MAVProxyUser/AlienWhoopF7/AlienWhoopF7-ESP32.brd

## EAGLE design AlienWhoopF7-ESP32.brd (2026-08-31)

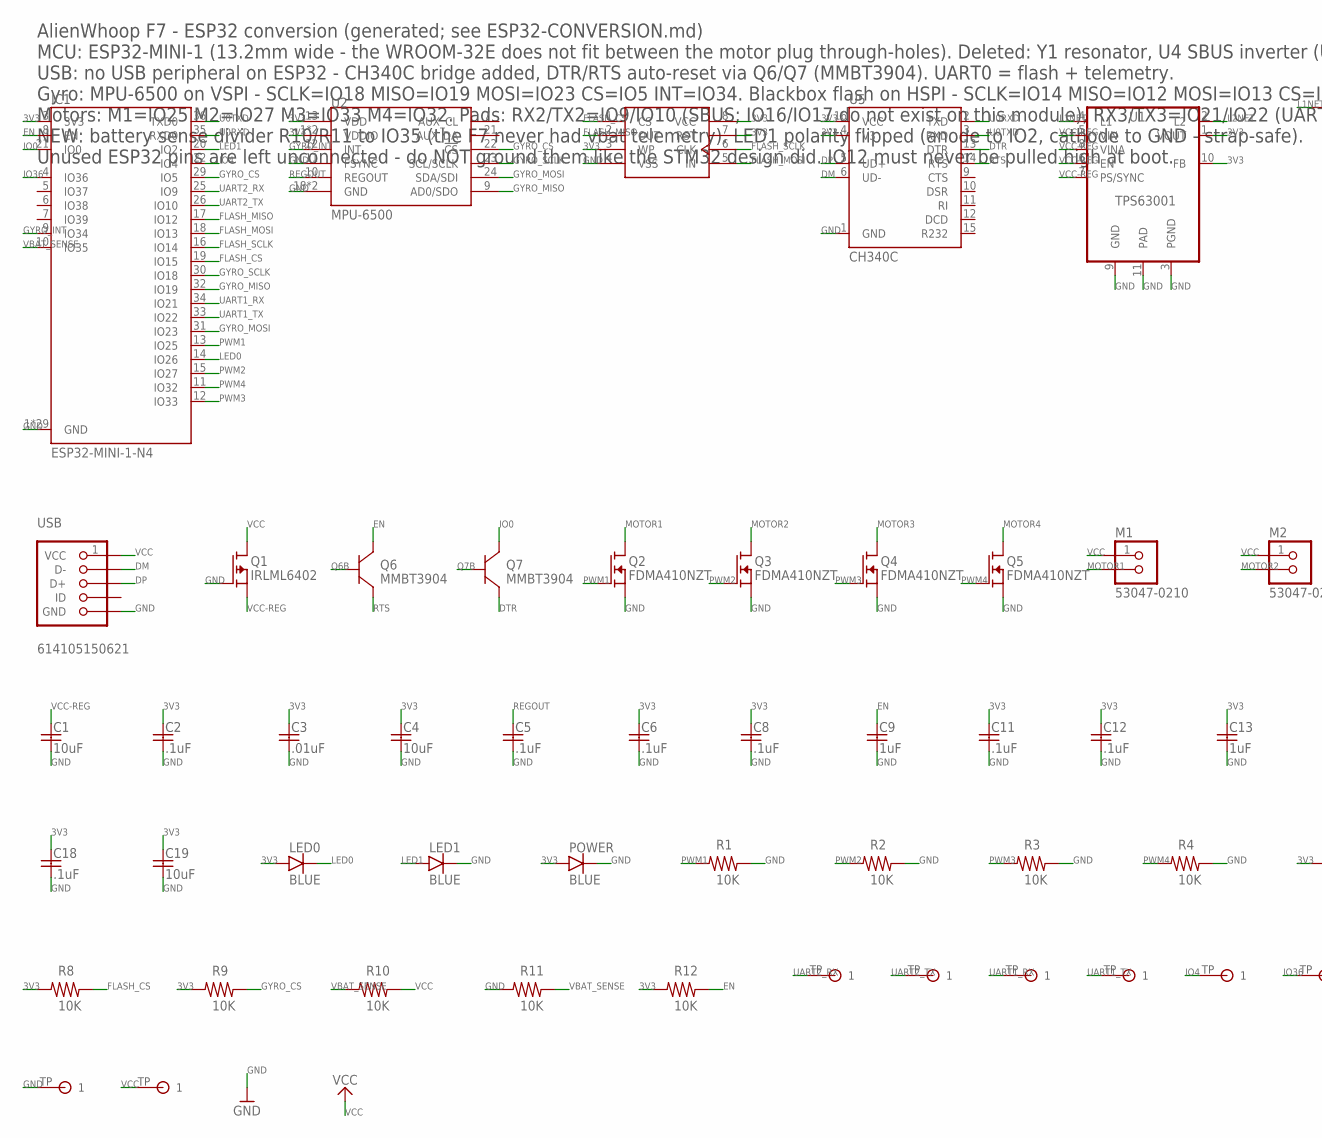
[picture p1: schematic AlienWhoopF7-ESP32.sch, part in row 1, column 1]

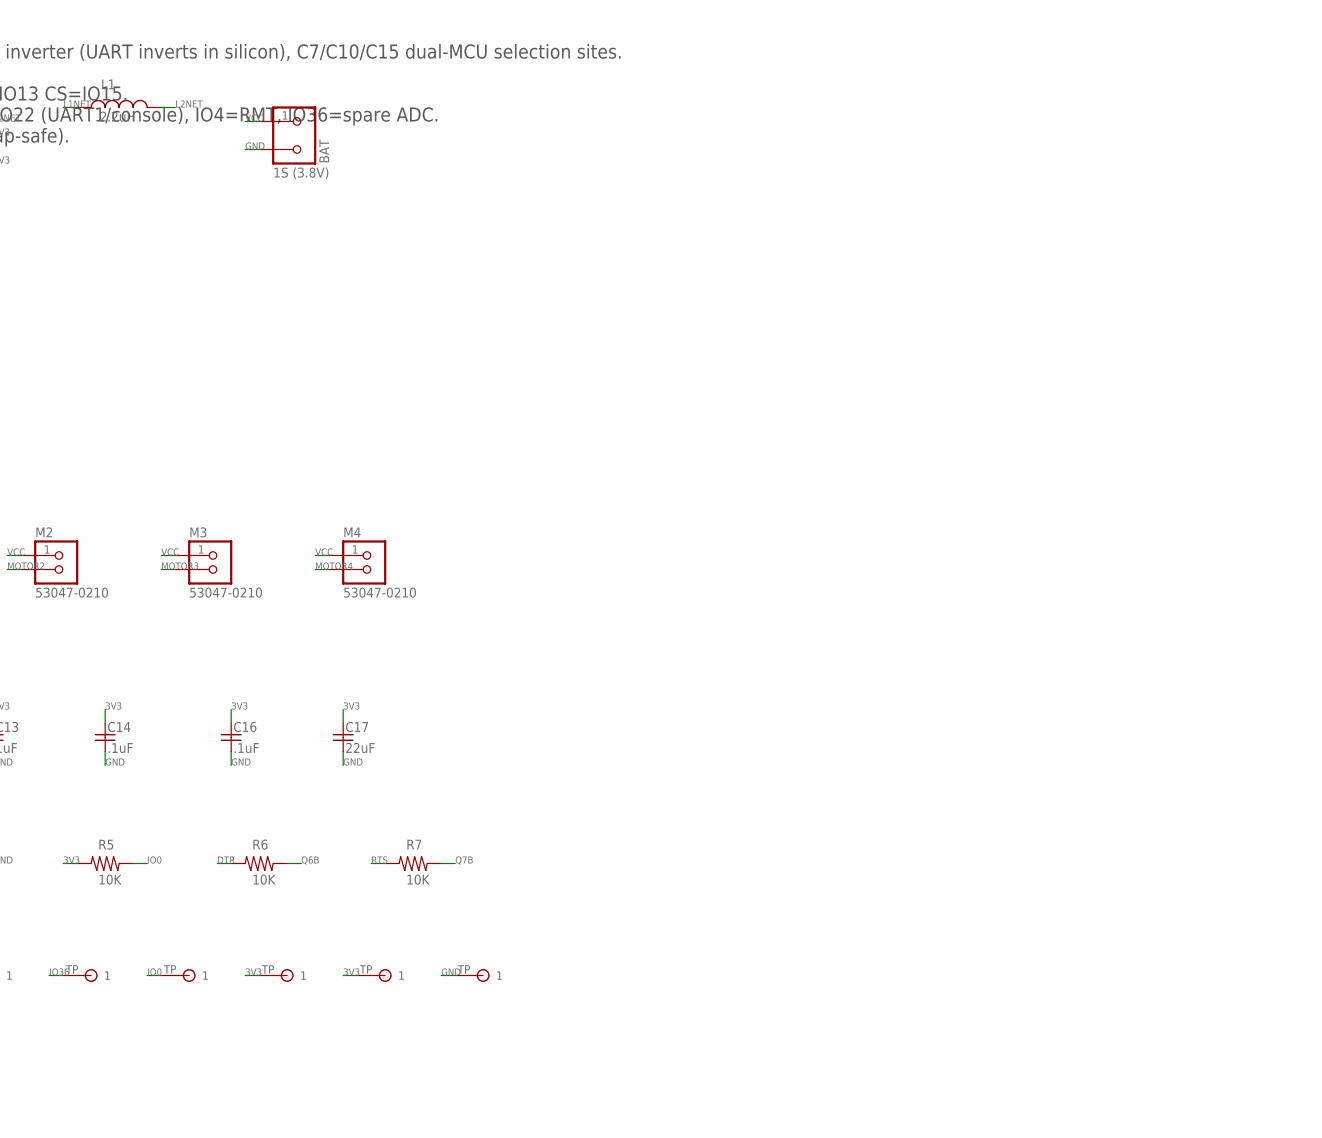
[picture p2: schematic AlienWhoopF7-ESP32.sch, part in row 1, column 2]

Parts:
3.3V, 3V3: TESTPAD
BAT: 1S (3.8V); S2B-PH-K-S
BOOT: TESTPAD
C1, C4, C19: 10uF; YUDEN-CAP-0805
C2, C5, C6, C8, C11, C12, C14, C16, C18: .1uF; MUR-CAP-0603
C3: .01uF; MUR-CAP-0603
C9, C13: 1uF; MUR-CAP-0603
C17: 22uF; YUDEN-CAP-0805
GND: TESTPAD
GND@1: TESTPAD
IC1: ESP32-MINI-1-N4; ESP32-MINI-1
IO4, IO36: TESTPAD
L1: 2.2uH; DFE201612E-2R2M-P2
LED0, LED1: BLUE; SMD-CHIP-LED-0805
M1, M2, M3, M4: 53047-0210; PICO-53047-02
POWER: BLUE; SMD-CHIP-LED-0805
Q1: IRLML6402; SOT-23
Q2, Q3, Q4, Q5: FDMA410NZT; MICROFET-2X2
Q6, Q7: MMBT3904; SOT23
R1, R2, R3, R4, R5, R6, R7, R8, R9, R10, R11, R12: 10K; VISH-RES-0603
RX2, RX3: TESTPAD
TX2, TX3: TESTPAD
U1: TPS63001; VSON-N10
U2: MPU-6500; QFN24_PAD
U3: MX25L6406EM2I-12G; M25P32
U5: CH340C; SOP16
USB: 614105150621; USB-BFPV
VCC@1: TESTPAD

Connections:
3V3: 3.3V.TP, 3V3.TP, C2.1, C3.1, C4.1, C6.1, C8.1, C11.1, C12.1, C13.1, C14.1, C16.1, C17.1, C18.1, C19.1, IC1.3 (3V3), LED0.A, POWER.A, R5.2, R8.2, R9.2, R12.2, U1.1 (VOUT), U1.10 (FB), U2.1 (VDDIO), U2.8 (VDDIO), U2.13 (VDD), U3.3 (WP), U3.7 (RST), U3.8 (VCC), U5.4 (V3), U5.16 (VCC)
DM: U5.6 (UD-), USB.2 (D-)
DP: U5.5 (UD+), USB.3 (D+)
DTR: Q7.2 (E), R6.2, U5.13 (DTR)
EN: C9.1, IC1.8 (EN), Q6.3 (C), R12.1
FLASH_CS: IC1.19 (IO15), R8.1, U3.1 (CS)
FLASH_MISO: IC1.17 (IO12), U3.2 (OUT)
FLASH_MOSI: IC1.18 (IO13), U3.5 (IN)
FLASH_SCLK: IC1.16 (IO14), U3.6 (CLK)
GND: BAT.2, C1.2, C2.2, C3.2, C4.2, C5.2, C6.2, C8.2, C9.2, C11.2, C12.2, C13.2, C14.2, C16.2, C17.2, C18.2, C19.2, GND.TP, GND@1.TP, IC1.1 (GND), IC1.2 (GND), IC1.27 (GND), IC1.38 (GND), IC1.39 (GND), IC1.40 (GND), IC1.41 (GND), IC1.42 (GND), IC1.43 (GND), IC1.44 (GND), IC1.45 (GND), IC1.46 (GND), IC1.47 (GND), IC1.48 (GND), IC1.49 (GND), IC1.50 (GND), IC1.51 (GND), IC1.52 (GND), IC1.53 (GND), IC1.54 (GND), IC1.55 (GND), IC1.T1 (GND), IC1.T2 (GND), IC1.T3 (GND), IC1.T4 (GND), IC1.T5 (GND), IC1.T6 (GND), IC1.T7 (GND), IC1.T8 (GND), LED1.C, POWER.C, Q1.1 (G), Q2.S, Q2.S1 (S), Q3.S, Q3.S1 (S), Q4.S, Q4.S1 (S), Q5.S, Q5.S1 (S), R1.1, R2.1, R3.1, R4.1, R11.2, U1.3 (PGND), U1.9 (GND), U1.11 (PAD), U2.11 (FSYNC), U2.18 (GND), U2.20 (GND), U3.4 (VSS), U5.1 (GND), USB.5 (GND), USB.P$6 (GND), USB.P$7 (GND)
GYRO_CS: IC1.29 (IO5), R9.1, U2.22 (!CS)
GYRO_INT: IC1.9 (IO34), U2.12 (INT)
GYRO_MISO: IC1.32 (IO19), U2.9 (AD0/SDO)
GYRO_MOSI: IC1.31 (IO23), U2.24 (SDA/SDI)
GYRO_SCLK: IC1.30 (IO18), U2.23 (SCL/SCLK)
IO0: BOOT.TP, IC1.21 (IO0), Q7.3 (C), R5.1
IO4: IC1.22 (IO4), IO4.TP
IO36: IC1.4 (IO36), IO36.TP
L1NET: L1.P$1 (1), U1.4 (L1)
L2NET: L1.P$2 (2), U1.2 (L2)
LED0: IC1.14 (IO26), LED0.C
LED1: IC1.20 (IO2), LED1.A
MOTOR1: M1.2, Q2.D, Q2.D1 (D), Q2.D2 (D), Q2.D3 (D), Q2.D4 (D)
MOTOR2: M2.2, Q3.D, Q3.D1 (D), Q3.D2 (D), Q3.D3 (D), Q3.D4 (D)
MOTOR3: M3.2, Q4.D, Q4.D1 (D), Q4.D2 (D), Q4.D3 (D), Q4.D4 (D)
MOTOR4: M4.2, Q5.D, Q5.D1 (D), Q5.D2 (D), Q5.D3 (D), Q5.D4 (D)
PWM1: IC1.13 (IO25), Q2.G, R1.2
PWM2: IC1.15 (IO27), Q3.G, R2.2
PWM3: IC1.12 (IO33), Q4.G, R3.2
PWM4: IC1.11 (IO32), Q5.G, R4.2
Q6B: Q6.1 (B), R6.1
Q7B: Q7.1 (B), R7.1
REGOUT: C5.1, U2.10 (REGOUT)
RTS: Q6.2 (E), R7.2, U5.14 (RTS)
U0RXD: IC1.35 (RXD0), U5.2 (TXD)
U0TXD: IC1.36 (TXD0), U5.3 (RXD)
UART1_RX: IC1.34 (IO21), RX3.TP
UART1_TX: IC1.33 (IO22), TX3.TP
UART2_RX: IC1.25 (IO9), RX2.TP
UART2_TX: IC1.26 (IO10), TX2.TP
VBAT_SENSE: IC1.10 (IO35), R10.2, R11.1
VCC: BAT.1, M1.1, M2.1, M3.1, M4.1, Q1.3 (D), R10.1, USB.1 (VCC), VCC@1.TP
VCC-REG: C1.1, Q1.2 (S), U1.5 (VIN), U1.6 (EN), U1.7 (PS/SYNC), U1.8 (VINA)

Notes on the sheet:
AlienWhoop F7 - ESP32 conversion (generated; see ESP32-CONVERSION.md)
MCU: ESP32-MINI-1 (13.2mm wide - the WROOM-32E does not fit between the motor plug through-holes). Deleted: Y1 resonator, U4 SBUS inverter (UART inverts in silicon), C7/C10/C15 dual-MCU selection sites.
USB: no USB peripheral on ESP32 - CH340C bridge added, DTR/RTS auto-reset via Q6/Q7 (MMBT3904). UART0 = flash + telemetry.
Gyro: MPU-6500 on VSPI - SCLK=IO18 MISO=IO19 MOSI=IO23 CS=IO5 INT=IO34. Blackbox flash on HSPI - SCLK=IO14 MISO=IO12 MOSI=IO13 CS=IO15.
Motors: M1=IO25 M2=IO27 M3=IO33 M4=IO32. Pads: RX2/TX2=IO9/IO10 (SBUS; IO16/IO17 do not exist on this module), RX3/TX3=IO21/IO22 (UART1/console), IO4=RMT, IO36=spare ADC.
NEW: battery sense divider R10/R11 to IO35 (the F7 never had vbat telemetry). LED1 polarity flipped (anode to IO2, cathode to GND - strap-safe).
Unused ESP32 pins are left unconnected - do NOT ground them like the STM32 design did. IO12 must never be pulled high at boot.

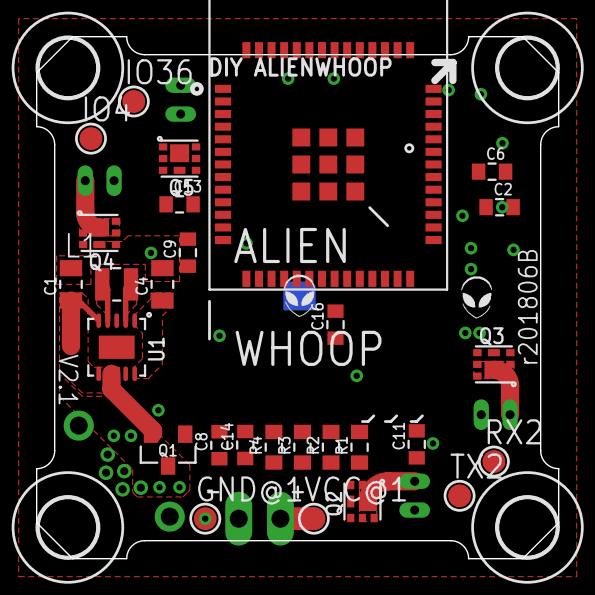
[picture p3: board AlienWhoopF7-ESP32.brd from above]

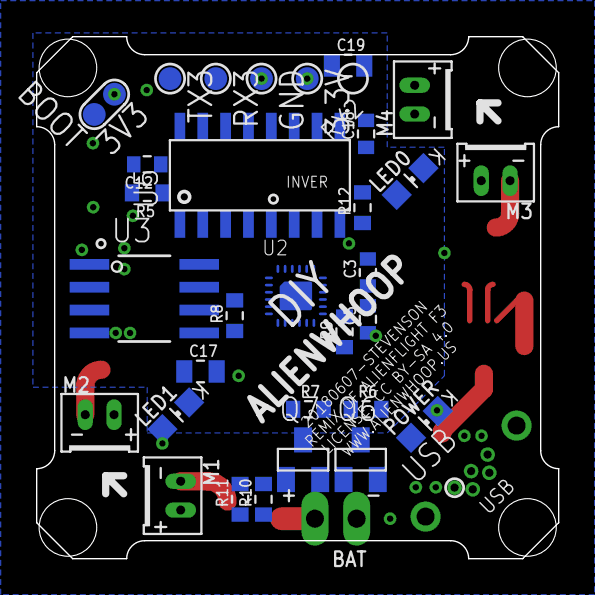
[picture p4: board AlienWhoopF7-ESP32.brd from below]

Board: 2 copper layers, 29.0 x 29.0 mm, 66 parts (34 on the bottom side), 43 nets.

Other parts of the board:
U$1, U$2, U$3, U$4: 3,2
