MAVProxyUser/AlienWhoopF7/(commit log)

2026-08-31 Add ESP32-WROOM-32E conversion: schematic, BOM, wiring plan
    Replaces the STM32F405/F722 (LQFP64) with an ESP32-WROOM-32E on the
    verified OpenPilotESP32 GPIO map: gyro VSPI 18/19/23 CS5 INT34,
    blackbox flash HSPI 14/12/13/15, motors 25/27/33/32. Adds CH340C
    USB-UART bridge with MMBT3904 auto-reset (no USB peripheral on
    ESP32), deletes the 8MHz resonator, SBUS inverter and VCAP caps,
    adds battery sensing on IO35. Generated, netlist-verified Eagle 9
    schematic; no layout yet.
    [AlienWhoopF7-ESP32.sch, AlienWhoopF7-ESP32_BOM.csv]
2026-08-31 Credit the F4/F7 dual-MCU passive-selection hack properly
    Review feedback from the original author: the C7/C10/C15 deletion read
    as dismissing a BOM quirk, when those three sites are actually the
    mechanism that lets one LQFP64 footprint take either an F405 or an
    F722 - they sit on the pins whose function differs between the two
    chips (C15 = F405 PB11 = F722 VCAP_1, hence the net name VCAP_1_F7),
    and cap-vs-0R population selects the chip. Documented as such; they
    are still deleted, since the ESP32 has no VCAP pins to select for.
    [AlienWhoopF7-ESP32_BOM.csv]
2026-08-31 Switch to ESP32-MINI-1 and add generated placement-study board
    The layout pass falsified the WROOM-32E: the motor-plug through-holes
    leave a 14.4mm corridor and the module is 18mm wide. The ESP32-MINI-1
    (13.2mm, same ESP32-U4WDH silicon family, same esp32 IDF target, 4MB
    in-package flash) fits with the antenna fully off the board edge. Its
    in-package flash consumes GPIO16/17, so the receiver UART moves to
    IO9/IO10 (the native U1RXD/U1TXD).
    AlienWhoopF7-ESP32.brd is a generated transplant of the original
    layout: all surviving parts keep their positions, GND/3V3 pours and
    unmoved power copper carry over, the gyro moves to board center on
    the bottom, the CH340C cluster takes the deleted invert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
    [AlienWhoopF7-ESP32.brd, AlienWhoopF7-ESP32.sch, AlienWhoopF7-ESP32_BOM.csv]
2026-08-31 Drop transplanted vias that touch ANY foreign or unconnected pad
    The keep/drop decision for a via near multiple pads depended on set
    iteration order: a GND via at (9.68, 22.07) touched both a C18 GND
    pad (same net, fine) and the module's unconnected IO39 pad (a short).
    Now a via survives only if every pad it touches is on its own net,
    and the check order is sorted for byte-stable regeneration.
    [AlienWhoopF7-ESP32.brd]
