MAVProxyUser/AlienWhoopF7/(notices)

Notices in the files:
AlienWhoopF7-ESP32.brd:
Released under the Creative Commons Attribution-ShareAlike 4.0 International License
https://creativecommons.org/licenses/by-sa/4.0
LICENSE: CC BY-SA 4.0
parts and their libraries:
alienflight: License: CC BY SA
alienflight: Released under the Creative Commons
Attribution Share-Alike 4.0 License
http://creativecommons.org/licenses/by-sa/4.0
SparkFun-Aesthetics: Licensing: Creative Commons ShareAlike 4.0 International - https://creativecommons.org/licenses/by-sa/4.0
